marshallamey/hydroponic-automation/documentation/HydroAutomation Budget.xlsx

Sheet: Used Items
Qty | Item | Manufacturer |  | Total Price | Product Description
1 | 1/2'' Black Tubing 25' (http://www.bihydro.com/) | Bright Ideas Aquaponis,Hydroponcs & Organics | http://www.bihydro.com/ | $10.95 | To add fittings to the flood table
2 | 1/4 in. -20 tpi x 4 in. Zinc-Plated Hex Bolt (http://www.homedepot.com/p/Everbilt-1-4-in-20-tpi-x-4-in-Zinc-Plated-Hex-Bolt-800656/204633305) | Everbilt | http://www.homedepot.com/p/Everbilt-1-4-in-20-tpi-x-4-in-Zinc-Plated-Hex-Bolt-800656/204633305 | $0.52 | To mount electrical equipment
1 | 1/4 in. -20 tpi Zinc-Plated Hex Nut (25-Pack) (http://www.homedepot.com/p/1-4-in-20-tpi-Zinc-Plated-Hex-Nut-25-Pack-802344/204274091?keyword=887480023442) |  | http://www.homedepot.com/p/1-4-in-20-tpi-Zinc-Plated-Hex-Nut-25-Pack-802344/204274091?keyword=887480023442 | $1.47 | To mount electrical equipment
1 | 1/4 in. Galvanized Bonded Sealing Washer (4-Piece) (http://www.homedepot.com/p/Everbilt-1-4-in-Galvanized-Bonded-Sealing-Washer-4-Piece-806738/204276438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) | Everbilt | http://www.homedepot.com/p/Everbilt-1-4-in-Galvanized-Bonded-Sealing-Washer-4-Piece-806738/204276438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 | $0.83 | To mount electrical equipment
1 | 1/4 in. Stainless Steel Split Lock Washer (6-Pack) (http://www.homedepot.com/p/Everbilt-1-4-in-Stainless-Steel-Split-Lock-Washer-6-Pack-800411/204276544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) | Everbilt | http://www.homedepot.com/p/Everbilt-1-4-in-Stainless-Steel-Split-Lock-Washer-6-Pack-800411/204276544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 | $1.18 | To mount electrical equipment
12 | 1-1/2 in. PVC Sch. 40 90-Degree S x S Elbow (http://www.homedepot.com/p/Charlotte-Pipe-1-1-2-in-PVC-Sch-40-90-Degree-S-x-S-Elbow-PVC023001400HD/203812129) | Charlotte Pipe & Foundry Co | http://www.homedepot.com/p/Charlotte-Pipe-1-1-2-in-PVC-Sch-40-90-Degree-S-x-S-Elbow-PVC023001400HD/203812129 | $18.12 | To construct prototype frame
5 | 1-1/2 in. PVC Sch. 40 90-Degree S x S x S x S Cross (http://www.homedepot.com/p/Charlotte-Pipe-1-1-2-in-PVC-Sch-40-S-x-S-x-S-x-S-Cross-PVC-02410-1200HD/203823993) | Charlotte Pipe & Foundry Co | http://www.homedepot.com/p/Charlotte-Pipe-1-1-2-in-PVC-Sch-40-S-x-S-x-S-x-S-Cross-PVC-02410-1200HD/203823993 | $23.00 | To construct prototype frame
3 | 1-1/2-in x 20-ft 0 Sch 40 PVC DWV Pipe (https://www.lowes.com/pd/Charlotte-Pipe-1-1-2-in-x-20-ft-0-Sch-40-PVC-DWV-Pipe/50168705) | Charlotte Pipe & Foundry Co | https://www.lowes.com/pd/Charlotte-Pipe-1-1-2-in-x-20-ft-0-Sch-40-PVC-DWV-Pipe/50168705 | $44.22 | To construct prototype frame
1 | 12v Dc Electric Solenoid Valve Water 3/4" female (https://www.amazon.com/HFS-Electric-Solenoid-Valve-Water/dp/B018WRJYOU) | Hardware Factory Store | https://www.amazon.com/HFS-Electric-Solenoid-Valve-Water/dp/B018WRJYOU | $20.00 | To regulate the flow of extra water
1 | 18-Pcs Aquarium suction cups for 3/16 airline tubing holder(black) (https://www.amazon.com/18-Pcs-Aquarium-Suction-suckers-Airline/dp/B01N0F8S36) | ZLPLL | https://www.amazon.com/18-Pcs-Aquarium-Suction-suckers-Airline/dp/B01N0F8S36 | $8.29 | To secure tubes entering the nutrient reservoir
1 | 25 ft. 16/3 Extension Cord (http://www.homedepot.com/p/HDX-25-ft-16-3-Extension-Cord-AW62601/100661460) | HDX | http://www.homedepot.com/p/HDX-25-ft-16-3-Extension-Cord-AW62601/100661460 | $9.68 | To power high voltage equipment
1 | 3/4'' Black Tubing 25' (http://www.bihydro.com/) | Bright Ideas Aquaponis,Hydroponcs & Organics | http://www.bihydro.com/ | $24.95 | To fill the flood table with water
1 | 32GB SD Card (https://www.walmart.com/ip/SanDisk-32GB-Class-4-SD-Card/23350706?wmlspartner=wlpa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) | SanDisk | https://www.walmart.com/ip/SanDisk-32GB-Class-4-SD-Card/23350706?wmlspartner=wlpa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 | $11.95 | To store data as a backup
1 | 34 Yellow In-Sure 4-Port Connector (10-Pack) (http://www.homedepot.com/p/Ideal-34-Yellow-In-Sure-4-Port-Connector-10-Pack-30-1334S/202911031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) | Ideal Industries | http://www.homedepot.com/p/Ideal-34-Yellow-In-Sure-4-Port-Connector-10-Pack-30-1334S/202911031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 | $2.58 | To make electrical connections
4 | 4 mm-0.7 Zinc-Plated Metric Hex Nut (2-Piece) (http://www.homedepot.com/p/Everbilt-4-mm-0-7-Zinc-Plated-Metric-Hex-Nut-2-Piece-803738/204275876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) | Everbilt | http://www.homedepot.com/p/Everbilt-4-mm-0-7-Zinc-Plated-Metric-Hex-Nut-2-Piece-803738/204275876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 | $1.48 | To mount electrical equipment
1 | 5L Dutchpro Grow Hydro/Coco A/B Set - Hydroponic Nutrients | Dutchpro |  | $68.95 | To provide nutrients for the plants
1 | 9 VDC 1000mA regulated switching power adapter (https://www.adafruit.com/product/63) | Adafruit Industries | https://www.adafruit.com/product/63 | $6.95 | To power the Arduino
1 | Active Aqua Air Pump, 2 Outlets, 3W, 7.8 L/min (https://www.amazon.com/Active-Aqua-Air-Pump-Outlets/dp/B002TCC46U) | Active Aqua | https://www.amazon.com/Active-Aqua-Air-Pump-Outlets/dp/B002TCC46U | $16.24 | To blow air into nutrient reservoir
1 | Active Aqua ASCL Air Stone Cylinder, Large (https://www.amazon.com/Active-ASCL-Stone-Cylinder-Large/dp/B00564IT5S) | Active Aqua | https://www.amazon.com/Active-ASCL-Stone-Cylinder-Large/dp/B00564IT5S | $6.84 | To add oxygen to nutrient reservoir
1 | Active Aqua Fill/Drain Combo Kit (http://www.bihydro.com/) | Bright Ideas Aquaponis,Hydroponcs & Organics | http://www.bihydro.com/ | $5.95 | To add light to the system
1 | Active Aqua Premium High Rise Flood Table for Tents, 22'' x 45'' (http://www.bihydro.com/) | Bright Ideas Aquaponis,Hydroponcs & Organics | http://www.bihydro.com/ | $69.95 | To drain water from the flood table
1 | Adafruit Assembled Data Logging shield for Arduino (https://www.adafruit.com/product/1141) | Adafruit Industres | https://www.adafruit.com/product/1141 | $13.95 | To store data as a backup
1 | ALITOVE 5V 10A AC to DC Power Supply Adapter (https://www.amazon.com/ALITOVE-Adapter-Converter-Charger-5-5x2-1mm/dp/B01M0KLECZ) | ALITOVE | https://www.amazon.com/ALITOVE-Adapter-Converter-Charger-5-5x2-1mm/dp/B01M0KLECZ | $21.99 | To power all 5V equipment
1 | Alpha Fry AT-31604 60-40 Rosin Core Solder (4 Ounces) (https://www.amazon.com/Alpha-AT-31604-60-40-Solder-Ounces/dp/B00030AP48) | Alpha Fry | https://www.amazon.com/Alpha-AT-31604-60-40-Solder-Ounces/dp/B00030AP48 | $8.32 | To use with soldering iron
1 | Analog Protoboard Adapter (https://www.vernier.com/products/accessories/protoboard-adapters/bta-elv/) | Vernier Software & Technologies | https://www.vernier.com/products/accessories/protoboard-adapters/bta-elv/ | $10.00 | To connect Vernier PAR sensor
1 | Arduino Mega Microcontroller (https://www.sparkfun.com/products/11061) | SparkFun Electronics | https://www.sparkfun.com/products/11061 | $45.95 | To run the automation program
1 | Atlas Scientific Conductivity Kit (https://www.atlas-scientific.com/product_pages/kits/ec_k1_0_kit.html) | Atlas Scientific LCC | https://www.atlas-scientific.com/product_pages/kits/ec_k1_0_kit.html | $195.71 | To measure conductivity
1 | Atlas Scientific Dissolved Oxygen Kit (https://www.atlas-scientific.com/product_pages/kits/do_kit.html) | Atlas Scientific LCC | https://www.atlas-scientific.com/product_pages/kits/do_kit.html | $257.45 | To measure dissolved oxygen
1 | Atlas Scientific pH Kit (https://www.atlas-scientific.com/product_pages/kits/ph-kit.html) | Atlas Scientific LCC | https://www.atlas-scientific.com/product_pages/kits/ph-kit.html | $149.15 | To measure pH
1 | Atlas Scientific PT-1000 Temperature Probe (https://www.atlas-scientific.com/product_pages/kits/temp_kit.html) | Atlas Scientific LCC | https://www.atlas-scientific.com/product_pages/kits/temp_kit.html | $61.99 | To measure water temperature
2 | Basic EZO™ Inline Voltage Isolator (https://www.atlas-scientific.com/product_pages/circuits/basic-ezo.html) | Atlas Scientific LCC | https://www.atlas-scientific.com/product_pages/circuits/basic-ezo.html | $48.00 | To electrically isolate pH and conductivity sensors
1 | Blusmart 100-Watt Industrial Glue Gun (https://www.amazon.com/Blusmart-100-Watt-Industrial-Temperature-Sticks/dp/B01MFB17FK) | Blusmart | https://www.amazon.com/Blusmart-100-Watt-Industrial-Temperature-Sticks/dp/B01MFB17FK | $29.97 | To shield connections that have been soldered
1 | Botanicare 20 Gallon Reservoir (https://www.zenhydro.com/botanicare-20-gallon-reservoir-lid.html) | Botanicare | https://www.zenhydro.com/botanicare-20-gallon-reservoir.html | $42.55 | To hold plants
1 | Botanicare 20 Gallon Reservoir Lid (https://www.zenhydro.com/botanicare-20-gallon-reservoir-lid.html) | Botanicare | https://www.zenhydro.com/botanicare-20-gallon-reservoir-lid.html | $29.90 | To hold nutrient solution
1 | Bread Board (http://www.intertexelectronics.com/PB101-Solderless-BreadBoard-P8986.aspx) | Major Brand | http://www.intertexelectronics.com/PB101-Solderless-BreadBoard-P8986.aspx | $7.95 | To make electrical connections
1 | Bread Board 400 Points (http://www.intertexelectronics.com/OSEPP-LS-00018-Breadboard-400-Tie-Points-P13243.aspx) | OSEPP | http://www.intertexelectronics.com/OSEPP-LS-00018-Breadboard-400-Tie-Points-P13243.aspx | $4.99 | To make electrical connections
1 | CR1220 12mm Diameter - 3V Lithium Coin Cell Battery - CR1220 (https://www.adafruit.com/product/380) | Adafruit Industres | https://www.adafruit.com/product/380 | $0.95 | To power the RTC
4 | Delta 1 Datatainer Chemical Storage Bottle 128-oz (One Gallon) (https://www.amazon.com/Delta-Datatainer-Storage-Bottle-Gallon/dp/B00009V3DO) | Delta | https://www.amazon.com/Delta-Datatainer-Storage-Bottle-Gallon/dp/B00009V3DO | $31.96 | To hold the nutrient solutions
1 | Electronix Express - Hook up Wire Kit (https://www.amazon.com/Electronix-Express-Hook-Stranded-Gauge/dp/B00B4ZQ3L0) | Electronix Express | https://www.amazon.com/Electronix-Express-Hook-Stranded-Gauge/dp/B00B4ZQ3L0 | $20.00 | To connect electrical components
1 | Elegoo 120pcs Multicolored Dupont Wire (https://www.amazon.com/Elegoo-120pcs-Multicolored-Breadboard-arduino/dp/B01EV70C78) | Elegoo | https://www.amazon.com/Elegoo-120pcs-Multicolored-Breadboard-arduino/dp/B01EV70C78 | $8.86 | To connect electrical components
1 | Elegoo EL-CK-002 Electronic Fun Kit (https://www.amazon.com/Elegoo-EL-CK-002-Electronic-Breadboard-Potentiometer/dp/B01ERP6WL4) | Elegoo | https://www.amazon.com/Elegoo-EL-CK-002-Electronic-Breadboard-Potentiometer/dp/B01ERP6WL4 | $12.86 | To provide various parts for electrical installation
1 | GE 8-Circuit 4-Space 125-Amp Main Lug Convertible Load Center (https://www.lowes.com/pd/GE-8-Circuit-4-Space-125-Amp-Main-Lug-Convertible-Load-Center/1082923) | General Electric | https://www.lowes.com/pd/GE-8-Circuit-4-Space-125-Amp-Main-Lug-Convertible-Load-Center/1082923 | $30.59 | To house electrical components
4 | Gikfun 12V DC Dosing Pump Peristaltic (https://www.amazon.com/Gikfun-Peristaltic-Connector-Aquarium-Analytic/dp/B01IUVHB8E) | Gikfun | https://www.amazon.com/Gikfun-Peristaltic-Connector-Aquarium-Analytic/dp/B01IUVHB8E | $50.64 | To dispense pH and nutrient solutions
1 | Gravity: UART Infrared CO2 Sensor (0-50000ppm) (https://www.dfrobot.com/product-1565.html) | DFRobot | https://www.dfrobot.com/product-1565.html | $93.00 | To measure carbon dioxide levels in the air
3 | Hubbell 15-Amp 125-Volt Yellow 3-Wire Connector (https://www.lowes.com/pd/Hubbell-15-Amp-125-Volt-Yellow-3-Wire-Connector/3739231) | Hubbell | https://www.lowes.com/pd/Hubbell-15-Amp-125-Volt-Yellow-3-Wire-Connector/3739231 | $19.14 | To power high voltage equipment
1 | JBtek 8 Channel DC 5V Relay Module for Arduino (https://www.amazon.com/JBtek-Channel-Relay-Arduino-Raspberry/dp/B00KTELP3I) | Jbtek | https://www.amazon.com/JBtek-Channel-Relay-Arduino-Raspberry/dp/B00KTELP3I | $8.98 | To power high voltage equipment via Arduino
16 | LASCO 1-1/2-in Dia PVC Sch 40 Tee (https://www.lowes.com/pd/LASCO-1-1-2-in-Dia-PVC-Sch-40-Tee/3344584) | LASCO Fittings, Inc. | https://www.lowes.com/pd/LASCO-1-1-2-in-Dia-PVC-Sch-40-Tee/3344584 | $28.48 | To construct prototype frame
1 | LCD Shield Kit w/ 16x2 Character Display (https://www.adafruit.com/product/772) | Adafruit Industries | https://www.adafruit.com/product/772 | $19.95 | To display level readings
1 | M4 Zinc-Plated Split Lock Washers (4-Piece) (http://www.homedepot.com/p/M4-Zinc-Plated-Split-Lock-Washers-4-Piece-803598/204276495?keyword=887480035988) |  | http://www.homedepot.com/p/M4-Zinc-Plated-Split-Lock-Washers-4-Piece-803598/204276495?keyword=887480035988 | $0.43 | To mount electrical equipment
2 | M4-.7 x 10 mm Plain Steel Metric Socket Cap Screw (2-Piece) (http://www.homedepot.com/p/Everbilt-M4-7-x-10-mm-Plain-Steel-Metric-Socket-Cap-Screw-2-Piece-803218/204274283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) | Everbilt | http://www.homedepot.com/p/Everbilt-M4-7-x-10-mm-Plain-Steel-Metric-Socket-Cap-Screw-2-Piece-803218/204274283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 | $1.04 | To mount electrical equipment
1 | OMEGAFLEX® Polypropylene Tubing - 100ft (https://www.omega.com/pptst/TYPP.html) | OMEGA | https://www.omega.com/pptst/TYPP.html | $20.50 | To dispense pH and nutrient solutions
1 | Particle Photon (https://store.particle.io/products/photon) | Particle |  | $19.00 | To connect to the internet
1 | pH UP and DOWN Solution (https://www.atlas-scientific.com/product_pages/chemicals/ph_up_down_1l.html) | Atlas Scientific LCC | https://www.atlas-scientific.com/product_pages/chemicals/ph_up_down_1l.html | $23.00 | To regulate pH level of the water
1 | Reliance Products Jumbo-Tainer 7 Gallon Jerry Can Style Rigid Water Container (https://www.amazon.com/Reliance-Products-Jumbo-Tainer-Gallon-Container/dp/B000GKDFH4/) | Reliance Products | https://www.amazon.com/Reliance-Products-Jumbo-Tainer-Gallon-Container/dp/B000GKDFH4/ | $23.28 | To store extra water
1 | Sigma Electric 10-Pack 3/8-in NM/SE Connector (https://www.lowes.com/pd/Sigma-Electric-10-Pack-3-8-in-NM-SE-Connector/3151125) | Sigma Electric Manufacturing Corporation | https://www.lowes.com/pd/Sigma-Electric-10-Pack-3-8-in-NM-SE-Connector/3151125 | $2.38 | To make electrical connections
1 | Sleek Airline Tubing in Black (https://www.amazon.com/Lees-Sleek-Airline-Tubing-25-Foot/dp/B001D4XTUU?linkId=953d8ddc03301af1036553c0ed085c5e) | Lee's Aquarium | https://www.amazon.com/Lees-Sleek-Airline-Tubing-25-Foot/dp/B001D4XTUU?linkId=953d8ddc03301af1036553c0ed085c5e | $5.24 | To connect air pump to air stone
2 | SMAKN® DHT22 / AM2302 Digital Temperature and Humidity measure sensor (https://www.amazon.com/Digital-Temperature-Humidity-measure-Arduino/dp/B018JO5BRK) | SMAKN | https://www.amazon.com/Digital-Temperature-Humidity-measure-Arduino/dp/B018JO5BRK | $19.98 | To measure air temperature and humidity
1 | Stanley 10 in. Dual Temp Glue Sticks (12 Pack) (https://www.amazon.com/Surebonder-BS-12-Temperature-Sticks-4-Inch/dp/B000BQUTMW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) | Surebonder | https://www.amazon.com/Surebonder-BS-12-Temperature-Sticks-4-Inch/dp/B000BQUTMWInch/dp/B000BQUTMW | $6.87 | To use with glue gun
1 | T5 Agrobrite 4'/6-Tube System w/bulbs (http://www.bihydro.com/) | Bright Ideas Aquaponis,Hydroponcs & Organics | http://www.bihydro.com/ | $202.95 | To provide light for the system
1 | USB Cable standard A-B 3’/1m (https://www.adafruit.com/product/62) | Adafruit Industries | https://www.adafruit.com/product/62 | $3.95 | To connect Arduino to computer
1 | Utilitech 25-Pack Plastic Wing Wire Connectors (https://www.lowes.com/pd/Utilitech-25-Pack-Plastic-Wing-Wire-Connectors/999953770) | Utilitech | https://www.lowes.com/pd/Utilitech-25-Pack-Plastic-Wing-Wire-Connectors/999953770 | $3.58 | To make electrical connections
1 | Vernier PAR Sensor (https://www.vernier.com/products/sensors/solar-radiation-sensors/par-bta/) | Vernier Software & Technologies |  | $199.00 | To measure PAR levels of light source
1 | Weller WLC100 40-Watt Soldering Station (https://www.amazon.com/Weller-WLC100-40-Watt-Soldering-Station/dp/B000AS28UC) | Weller | https://www.amazon.com/Weller-WLC100-40-Watt-Soldering-Station/dp/B000AS28UC | $35.11 | To solder wired connections
1 | WiFi Antenna (https://store.particle.io/products/antenna) | Particle |  | $10.00 | To strengthen WiFi signal
1 | YGDZ Top Quality 2 Pack Desoldering Wick (https://www.amazon.com/YGDZ-Quality-Desoldering-Removal-Shipping/dp/B01H3BVXLI) | YGDZ | https://www.amazon.com/YGDZ-Quality-Desoldering-Removal-Shipping/dp/B01H3BVXLI | $7.99 | To remove excess solder or to desolder connections
 |  | TOTAL EXPENSES: |  | $2191.68

Sheet: Unused Items
1 | Arduino WiFi Shield 101 |  |  | https://www.adafruit.com/product/2891 | 2891 | $49.95 | $49.95
1 | 12" eTape Liquid Level Sensor + extras (https://www.adafruit.com/product/464) | Adafruit Industries | Adafruit Industries | https://www.adafruit.com/product/464 | PID: 464 | $39.95 | $39.95
1 | 1N4001 Diode - 10 pack (https://www.adafruit.com/product/755) | Adafruit Industries | Adafruit Industries | https://www.adafruit.com/product/755 | PID: 755 | $1.50 | $1.50 | to avoid a negative-voltage that would zap your delicate electronics
1 | 4-channel I2C-safe Bi-directional Logic Level Converte r - BSS138 (https://www.adafruit.com/product/757) | Adafruit Industries | Adafruit Industries | https://www.adafruit.com/product/757 | PID: 757 | $3.95 | $3.95
2 | Dual H-Bridge Motor Driver for DC or Steppers - 600mA - L293D (https://www.adafruit.com/product/807) | Adafruit Industries | Adafruit Industries | https://www.adafruit.com/product/807 | PID: 807 | $2.95 | $5.90 | To run pump motors (1 driver runs 2 pumps)
1 | Flow Rate Meter (https://www.atlas-scientific.com/product_pages/probes/1-2_flow_meter.html) | Atlas Scientific LCC | Atlas Scientific LCC | https://www.atlas-scientific.com/product_pages/probes/1-2_flow_meter.html | Part # SEN-204F | $99.00 | $99.00
5 | P-Channel MOSFET 60V 27A (https://www.sparkfun.com/products/10349) | SparkFun Electronics | SparkFun Electronics | https://www.sparkfun.com/products/10349 | COM-10349 | $0.95 | $4.75
3 | WiFi Module - ESP8266 (https://www.sparkfun.com/products/13678) | SparkFun Electronics | SparkFun Electronics | https://www.sparkfun.com/products/13678 | WRL-13678 ROHS | $6.95 | $20.85 | To transmit data wirelessly
 | Basic EZO™ Inline Voltage Isolator (https://www.atlas-scientific.com/product_pages/circuits/basic-ezo.html) | Atlas Scientific LCC | Atlas Scientific LCC | https://www.atlas-scientific.com/product_pages/circuits/basic-ezo.html | Part # BE-IVI | $24.00 | $48.00
2 | BrassCraft 1/2-in x 1/2-in Barbed Barb x MIP Adapter Fitting (https://www.lowes.com/pd/BrassCraft-1-2-in-x-1-2-in-Barbed-Barb-x-MIP-Adapter-Fitting/50359362) | Lowe's | BassCraft | https://www.lowes.com/pd/BrassCraft-1-2-in-x-1-2-in-Barbed-Barb-x-MIP-Adapter-Fitting/50359362 | Item # 645668 | $4.19 | $8.38
1 | BrassCraft 1/2-in x 3/4-in Barbed Barb x Garden Hose Adapter Fitting (https://www.lowes.com/pd/BrassCraft-1-2-in-x-3-4-in-Barbed-Barb-x-Garden-Hose-Adapter-Fitting/50380954) | Lowe's | BassCraft | https://www.lowes.com/pd/BrassCraft-1-2-in-x-3-4-in-Barbed-Barb-x-Garden-Hose-Adapter-Fitting/50380954 | Item # 645836 | $7.98 | $7.98
