marshallamey/hydroponic-automation/(threads)

Thread 14 (2019-04-04):

TCPClient

DanAglinao0522, 2019-04-04:
How can i compile the PhotonToThingSpeak.ino on my Arduino?

The Error is
TCPClient is

Thread 15 (2024-01-16):

i don get to load sensor.h and motor.h libraries.

RootKaizer, 2024-01-16:
I tried to test your program, but i can't import libraries: Motor.h and Sensor.h in my Arduino IDE 2.2.

I moved libraries imported in this protect to Arduino library directory, later rebooted my Arduino IDE and I tried code compile,  it filed with the next message: "Compilation error: Sensor.h: No such file or directory"
this case pass same with Motor.h library "Compilation error: Motor.h: No such file or directory"

You can explain how to import these libraries???

RootKaizer, 2024-01-16:
i get the answer

Closed 2024-01-16.
