marshallamey/hydroponic-automation/documentation/wiring schematic.PDF

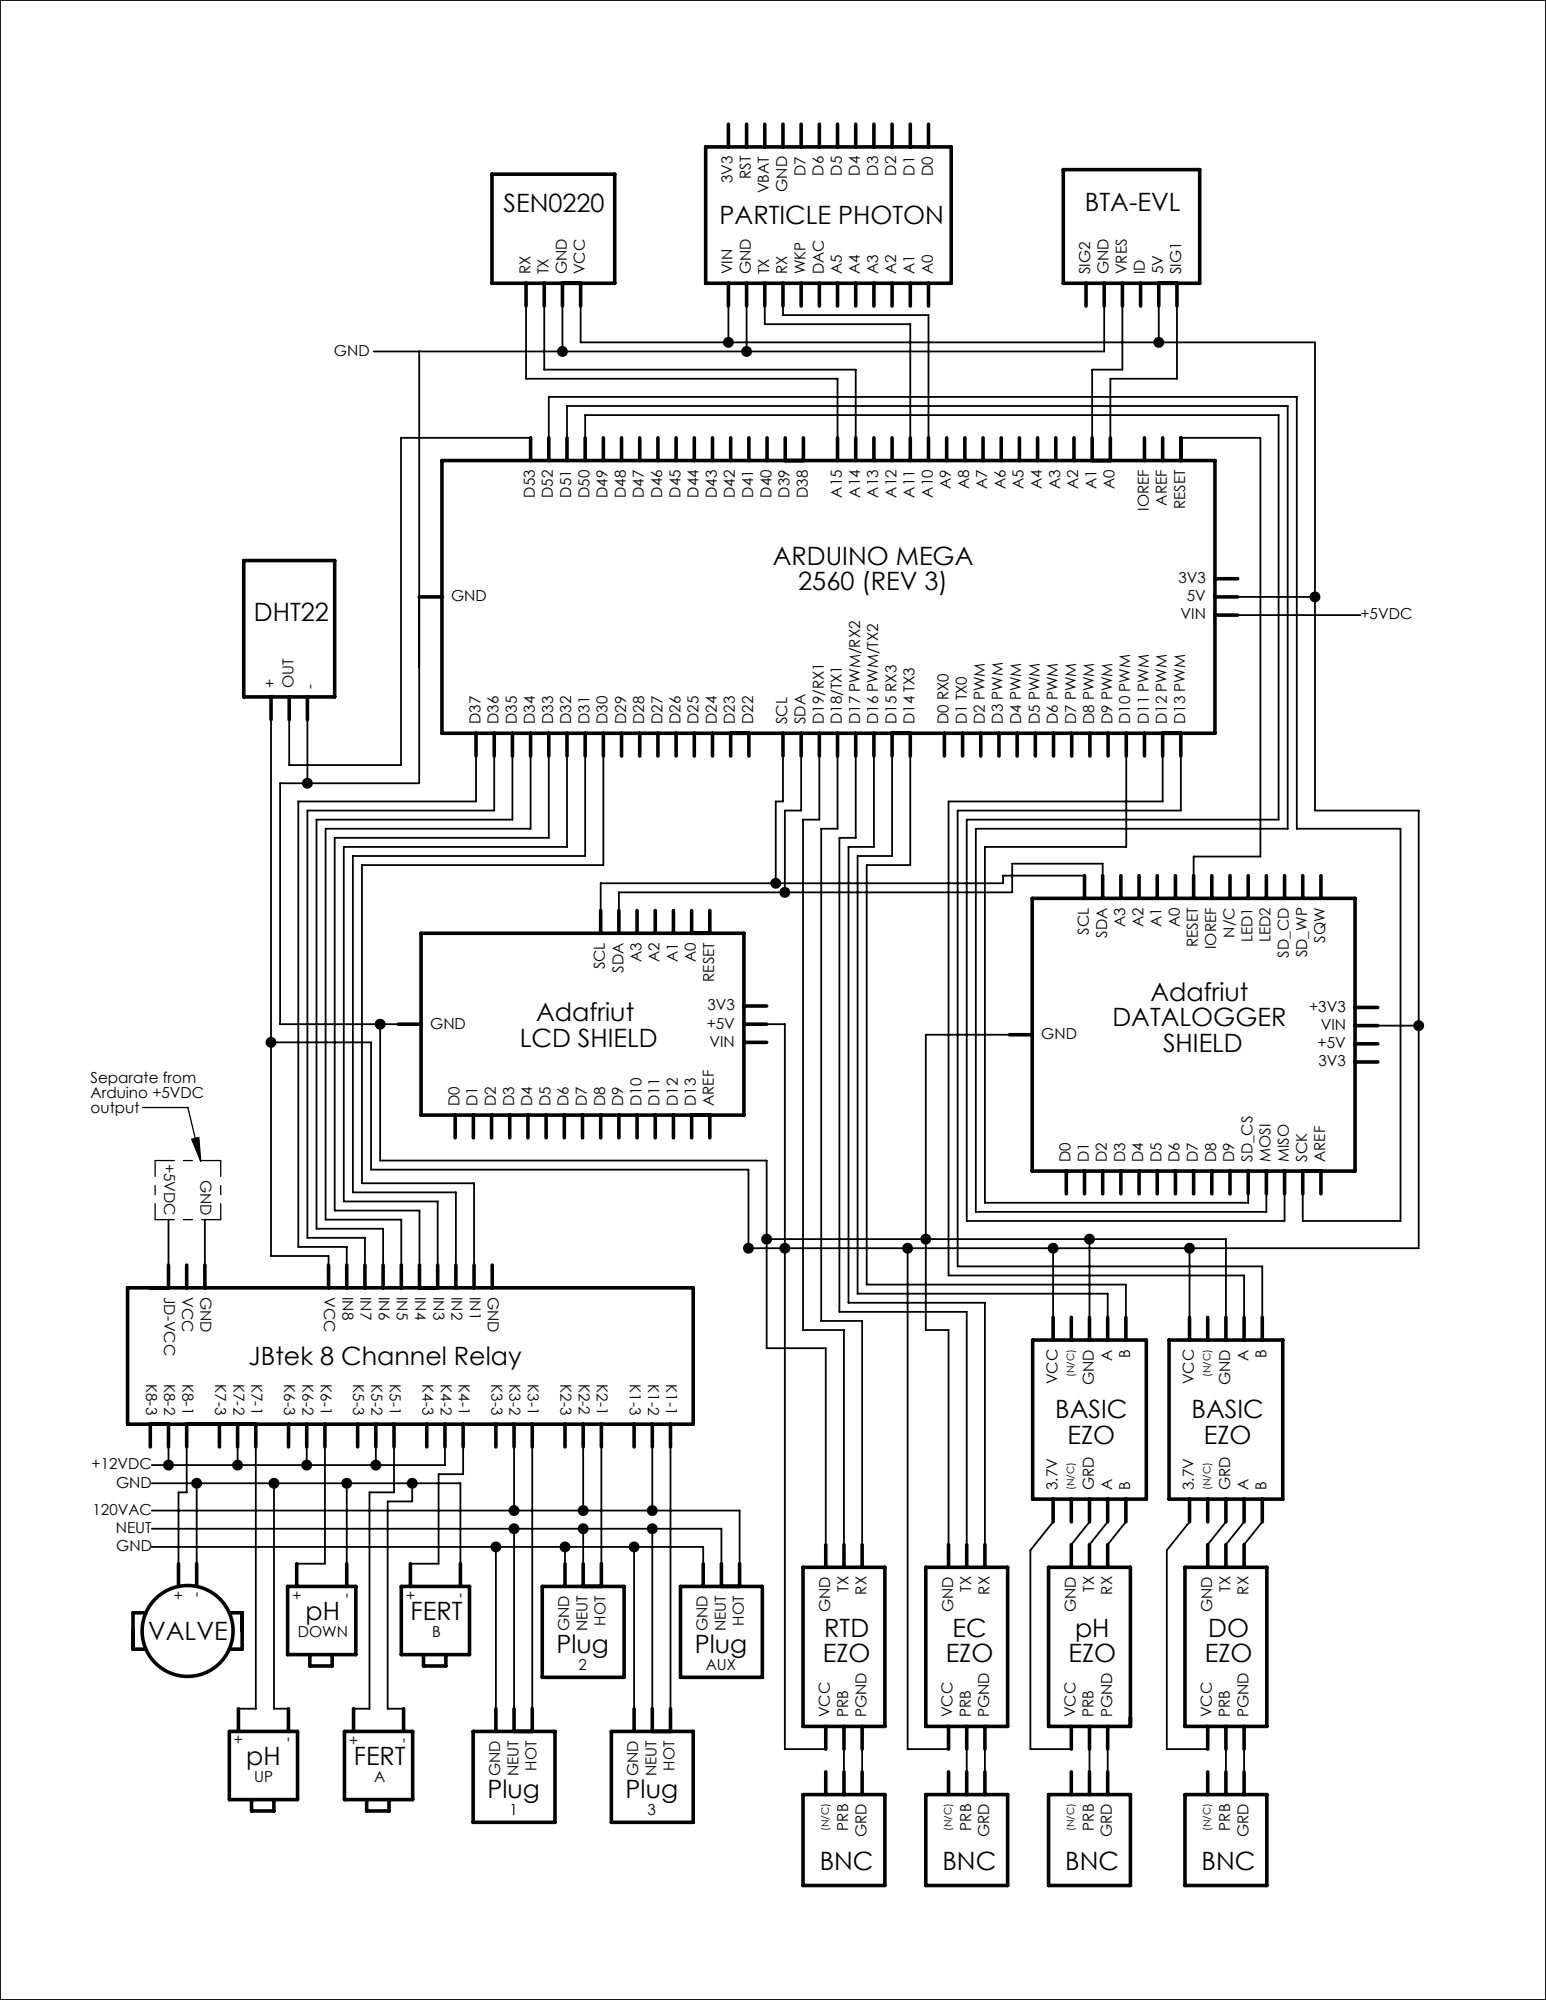
[picture p24: page 1]

PARTICLE PHOTON D7 D6 D5 D4 D3 D2 D1 D0 GNDRST VBAT 3V3

BTA-EVL SIG2 GND VRES ID5VSIG1

EZOVCC PRB PGND TXRX GND

RTD
