marshallamey/hydroponic-automation/(commit log)

2017-06-06 Create sensorInputs
2017-06-08 Create phSensor.ino
    Code to use with the ph Sensor from Atlas Scientific
2017-06-08 Create hydroponicAutomation.ino
    Added pH sensor and DHT sensor to sketch
2017-06-09 Add files via upload
    temperature and humidity display on LCD shield for arduino MEGA
2017-06-12 Update hydroponicAutomation.ino
    Added conductivity sensor
2017-06-12 Update hydroponicAutomation.ino
    Changed sensor code to get rid of if statements
2017-06-13 Add files via upload
    Basic sketch for turning on relay board
2017-06-14 Update hydroponicAutomation.ino
    Updated sensor communication functionality
2017-06-15 Create menu.ino
    Added sensor and utilities sub-menus
2017-06-19 Create sensorCode
2017-06-21 Update sensorCode
2017-06-25 Update masterSketch.ino
    Broke the larger functions into smaller ones.
    Reorganized the programs into 5 main functions:
    sendCommand(); - For sending commands to Atlas Sensors
    readData(); - For reading data from all sensors
    lcdMenu(); - For displaying data on the LCD screen and creating a menu for user interface
    monitorSolution(); - For checking the parameters of the solution and making necessary changes
    thingSpeak(); - For communicating with the Internet and storing data
2017-07-02 Create Sensor.h
    Library to hold all sensor functions
2017-07-02 Update masterSketch.ino
    Send, read, and print commands are now functional using the Sensor.h library
2017-07-02 Update and rename masterSketch.ino to hydroponicAutomation.ino
    Renamed sketch, created a Motor class, finished basic menu.
    Will add menu class next.
2017-07-21 Changed ThingSpeak update method and added software reset
    [hydroponicAutomation.ino]
2017-07-22 Added manageLights()
    Rewired electrical connections, added new 12v adapter, solenoid valve is now functional, lights programmed (11pm-3pm ON)
2017-07-22 Create sensor_readings
2017-07-25 Added last sensor reading and restricted graph
2017-07-31 Basic code for relaying serial info
2017-08-01 Create testRelay
    Program to test relay functionality
2017-08-01 Rename testRelay to testRelay.ino
    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
